Picatout/spider_web/octogon.png

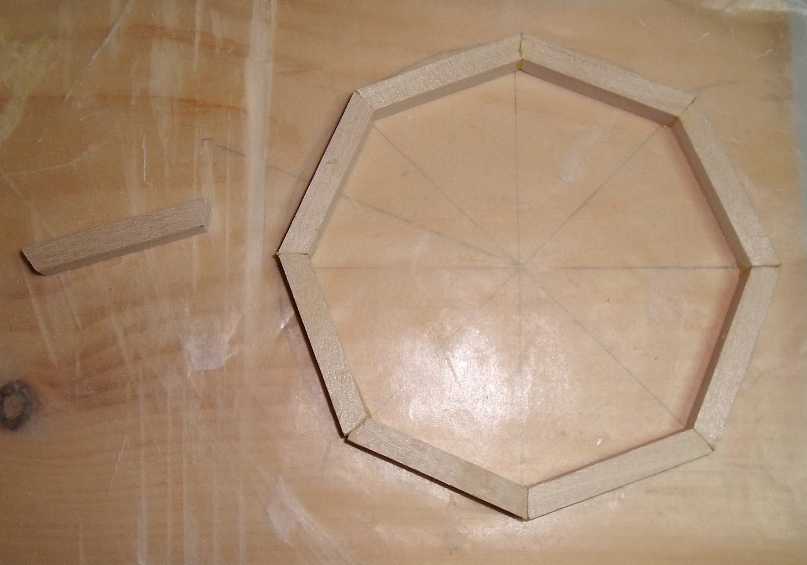
octogon.png
