Picatout/spider_web/octogon_drawing.png

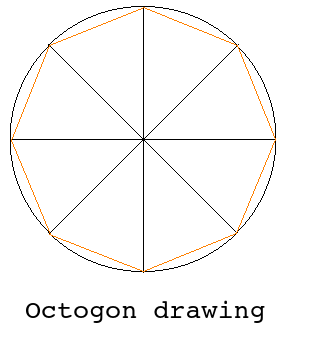
octogon_drawing.png
