Picatout/spider_web/top_view_ligth_on.png

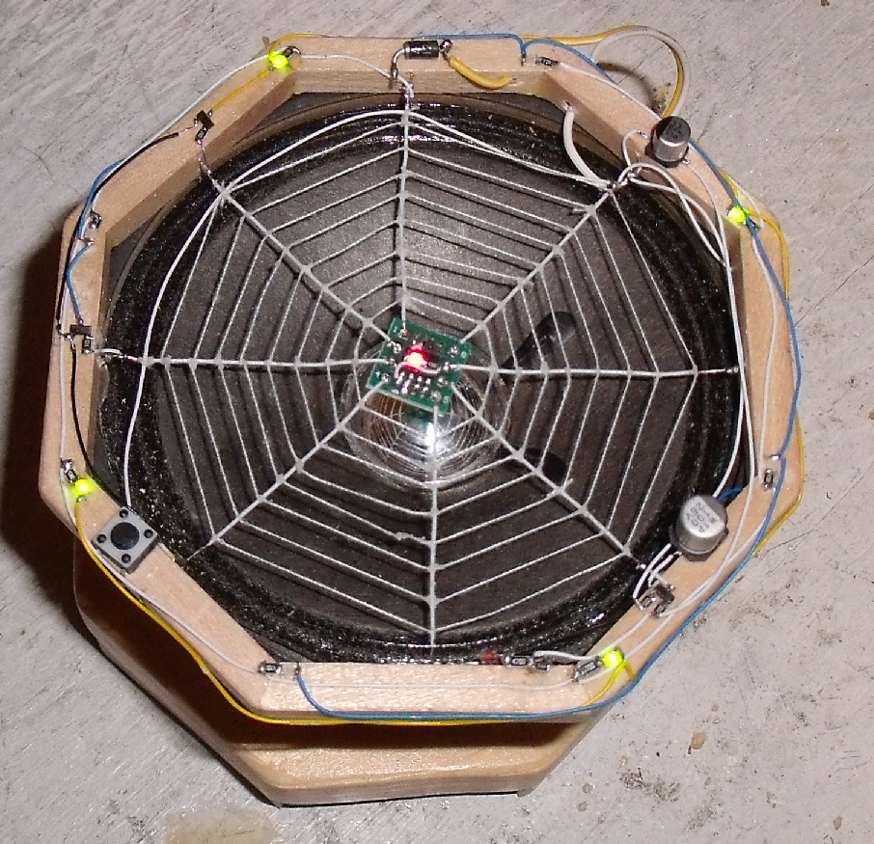
top_view_ligth_on.png
