Picatout/spider_web/f1572_mb/f1572_mb.sch

## KiCad design f1572_mb/f1572_mb.sch (2018-12-16)

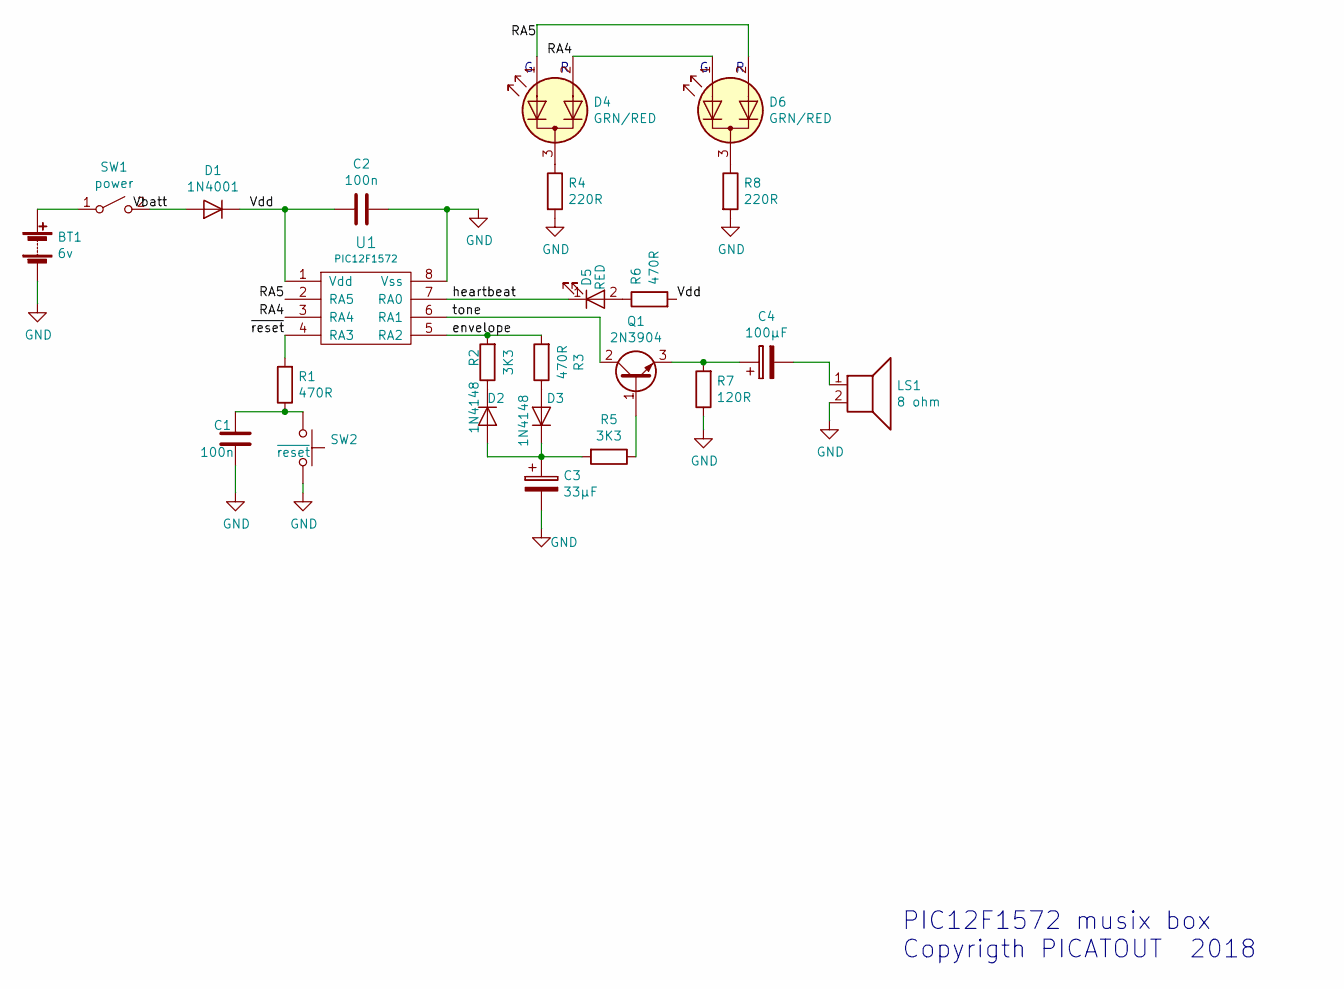
[picture p9: schematic f1572_mb.sch]

Parts:
BT1: 6v
C1, C2: 100n
C3: 33µF
C4: 100µF
D1: 1N4001
D2, D3: 1N4148
D4, D6: GRN/RED
D5: RED
LS1: 8 ohm
Q1: 2N3904
R1, R3, R6: 470R
R2, R5: 3K3
R4, R8: 220R
R7: 120R
SW1: power
SW2: ~reset
U1: PIC12F1572

Connections:
GND: BT1.2 (-), C1.1, C2.1, C3.2, LS1.2, R4.2, R7.1, R8.2, SW2.2, U1.8 (Vss)
unnamed: BT1.1 (+), SW1.1 (A)
unnamed: C1.2, R1.1, SW2.1
unnamed: C3.1, D2.2 (A), D3.1 (K), R5.2
unnamed: C4.1, Q1.3 (E), R7.2
unnamed: C4.2, LS1.1
unnamed: D2.1 (K), R2.1
unnamed: D3.2 (A), R3.1
unnamed: D4.3 (K), R4.1
unnamed: D5.2 (A), R6.1
unnamed: D6.3 (K), R8.1
unnamed: Q1.1 (B), R5.1
RA4: D4.2 (A2), D6.1 (A1), U1.3 (RA4)
RA5: D4.1 (A1), D6.2 (A2), U1.2 (RA5)
Vbatt: D1.2 (A), SW1.2 (B)
Vdd: C2.2, D1.1 (K), R6.2, U1.1 (Vdd)
envelope: R2.2, R3.2, U1.5 (RA2)
heartbeat: D5.1 (K), U1.7 (RA0)
tone: Q1.2 (C), U1.6 (RA1)
~reset: R1.2, U1.4 (RA3)

Notes on the sheet:
PIC12F1572 musix box Copyrigth PICATOUT 2018
