Picatout/spider_web/(commit log)

2018-12-16 change to schematic
    [f1572_mb.sch]
2018-12-20 Create v2 folder and copied project file to this folder. Modified schematic
    [f1572_mb.kicad_pcb, f1572_mb.sch]
2018-12-21 added png of schematic, updated readme.md
    [f1572_mb.sch]
2018-12-24 added photos project completed
    [f1572_mb.sch]
2018-12-24 removed version 1
    [f1572_mb.kicad_pcb, f1572_mb.sch]
